puddingsteve/8-Bit-CPU/Uploads/Schematics/ALU.png

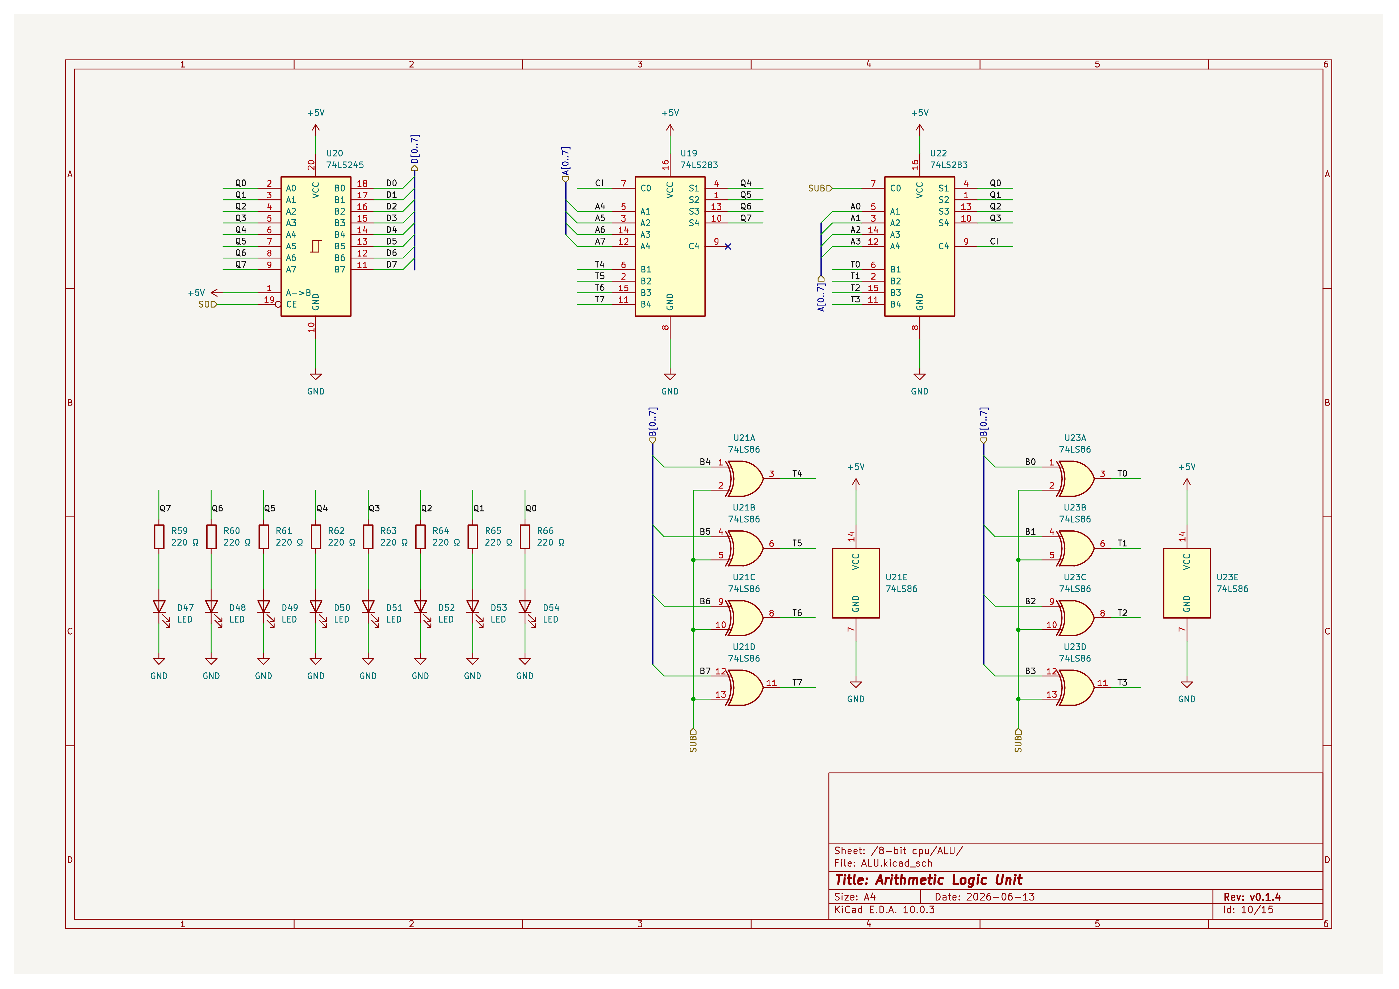
Uploads/Schematics/ALU.png
