puddingsteve/8-Bit-CPU/Uploads/Schematics/Bus Monitor.png

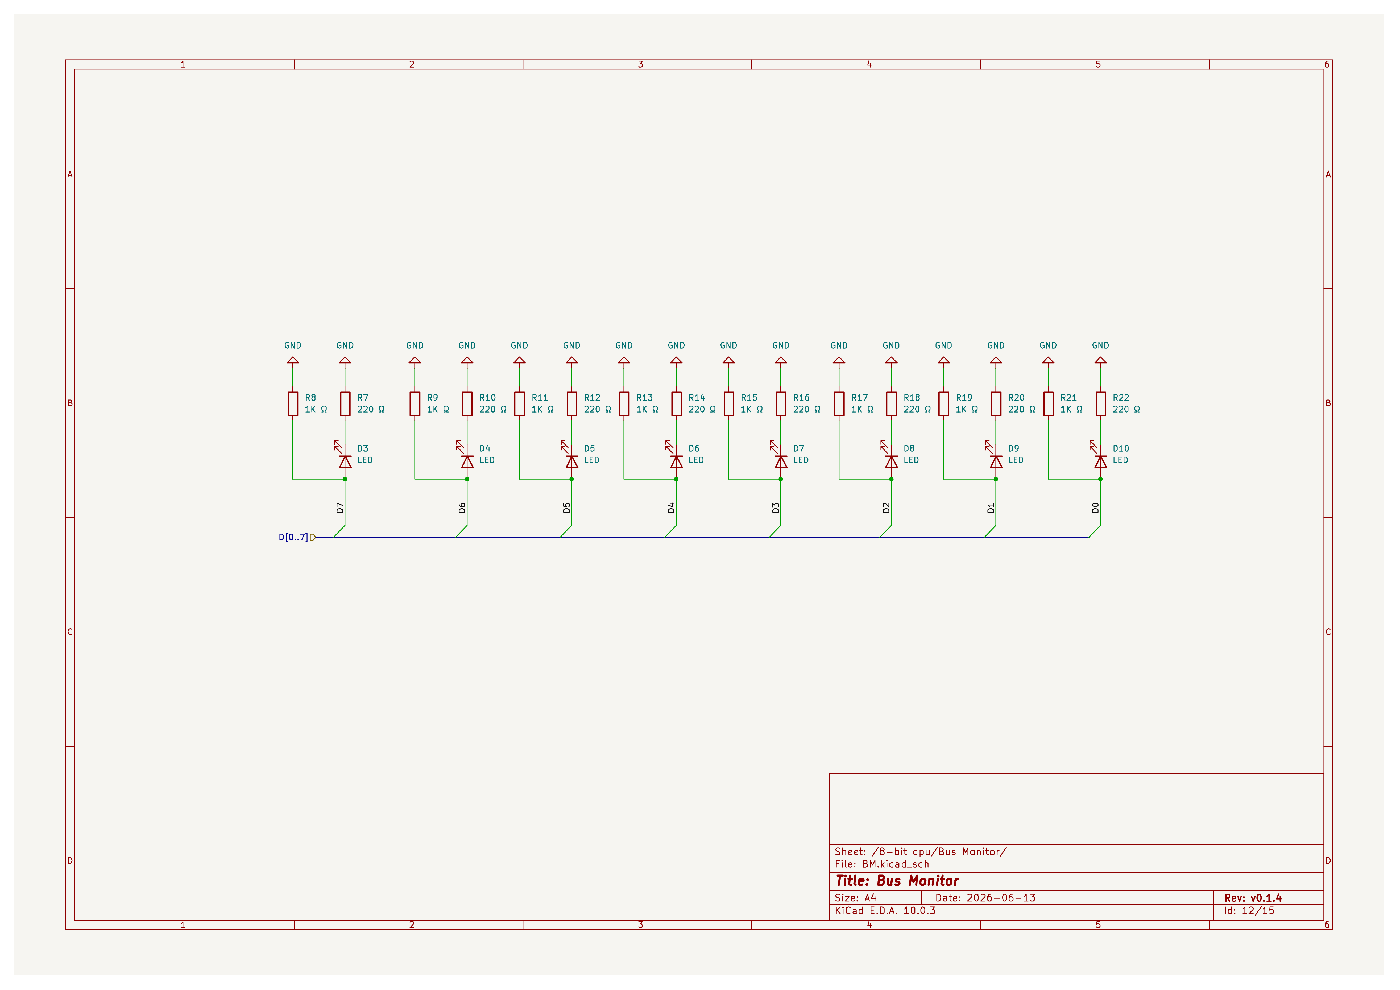
Uploads/Schematics/Bus Monitor.png
