puddingsteve/8-Bit-CPU/Uploads/Schematics/Clock.png

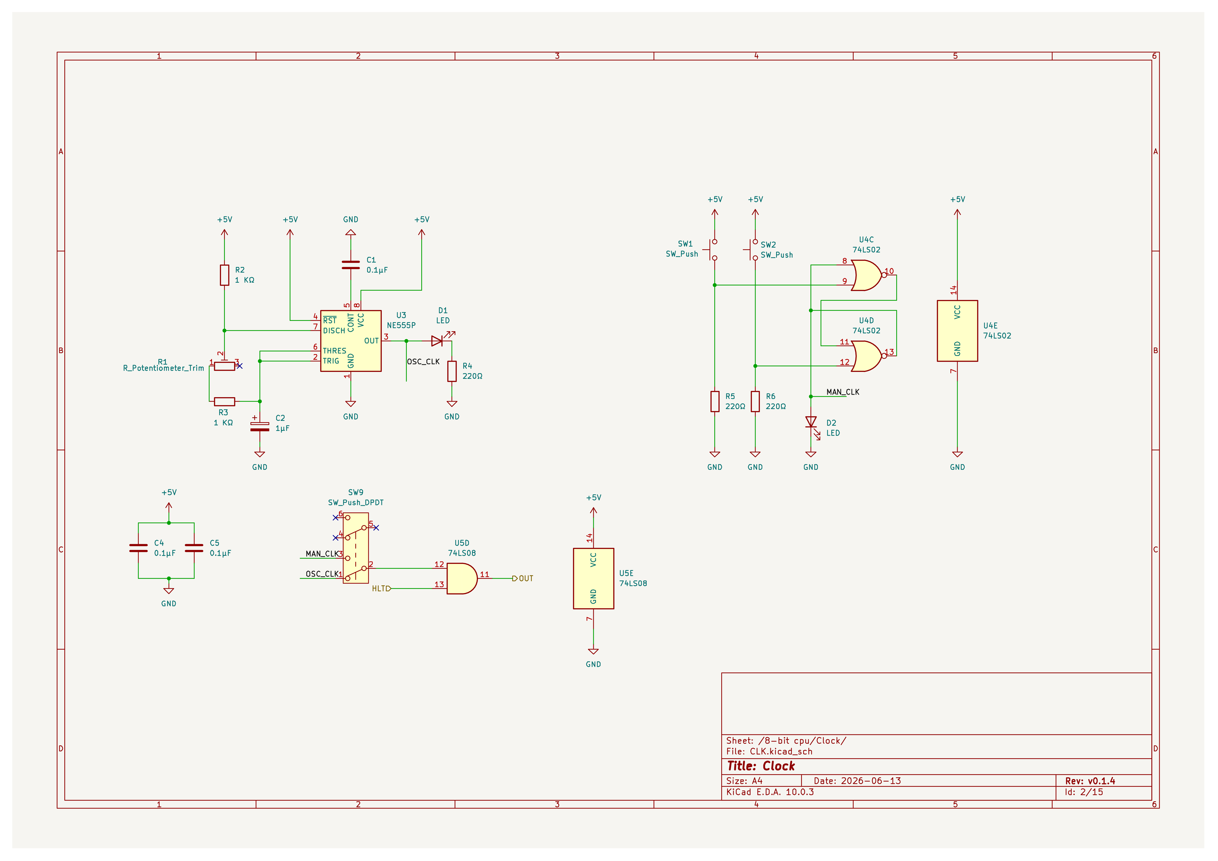
Uploads/Schematics/Clock.png
