puddingsteve/8-Bit-CPU/Uploads/Schematics/Control Unit.png

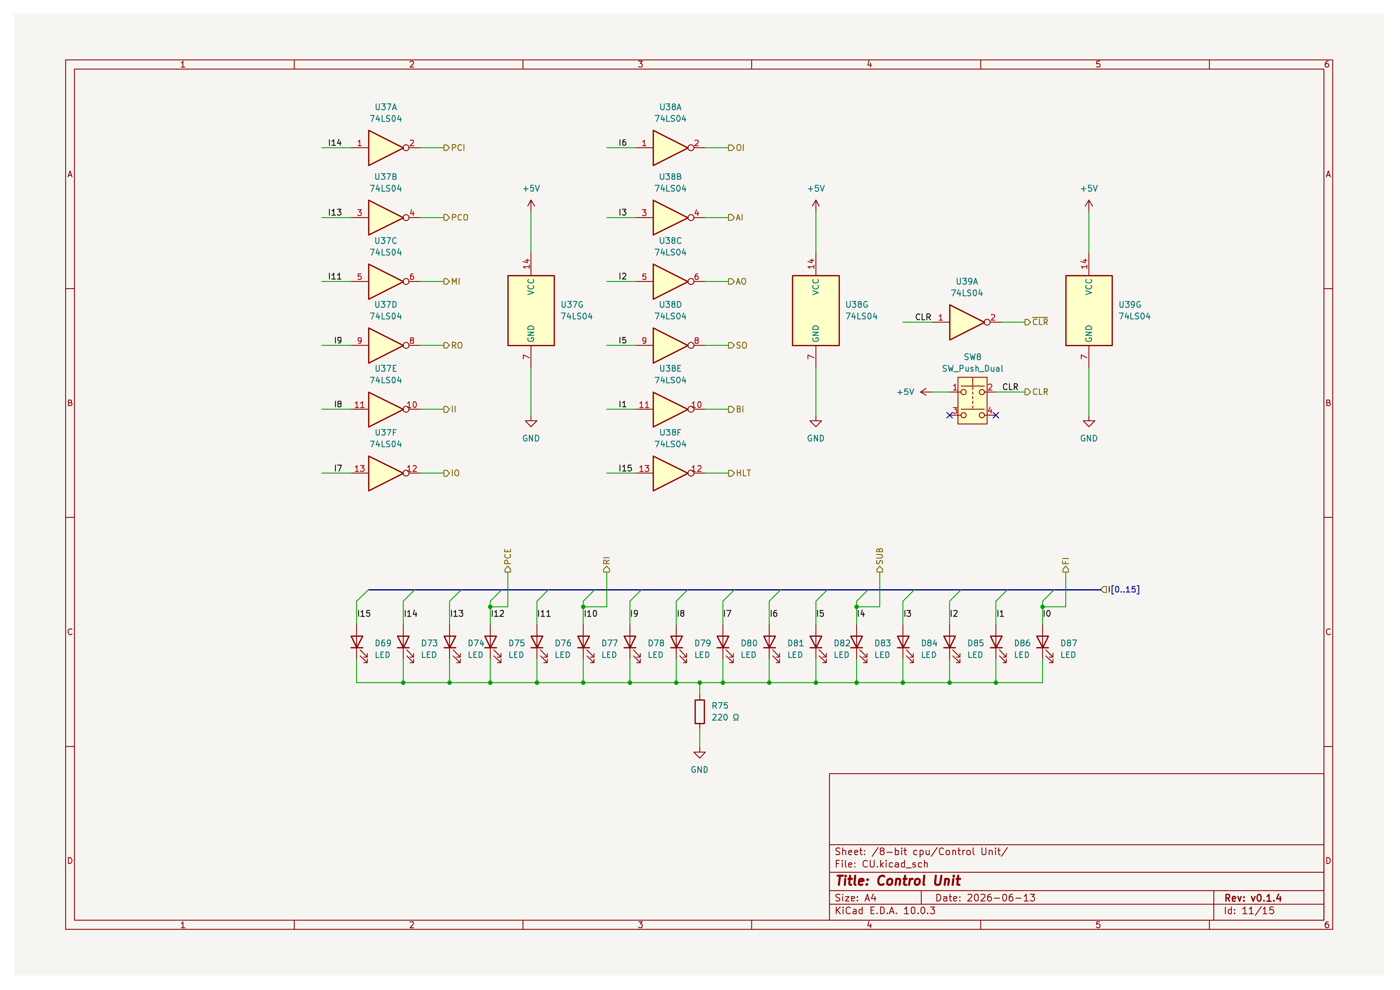
Uploads/Schematics/Control Unit.png
