puddingsteve/8-Bit-CPU/Uploads/Schematics/EEPROM.png

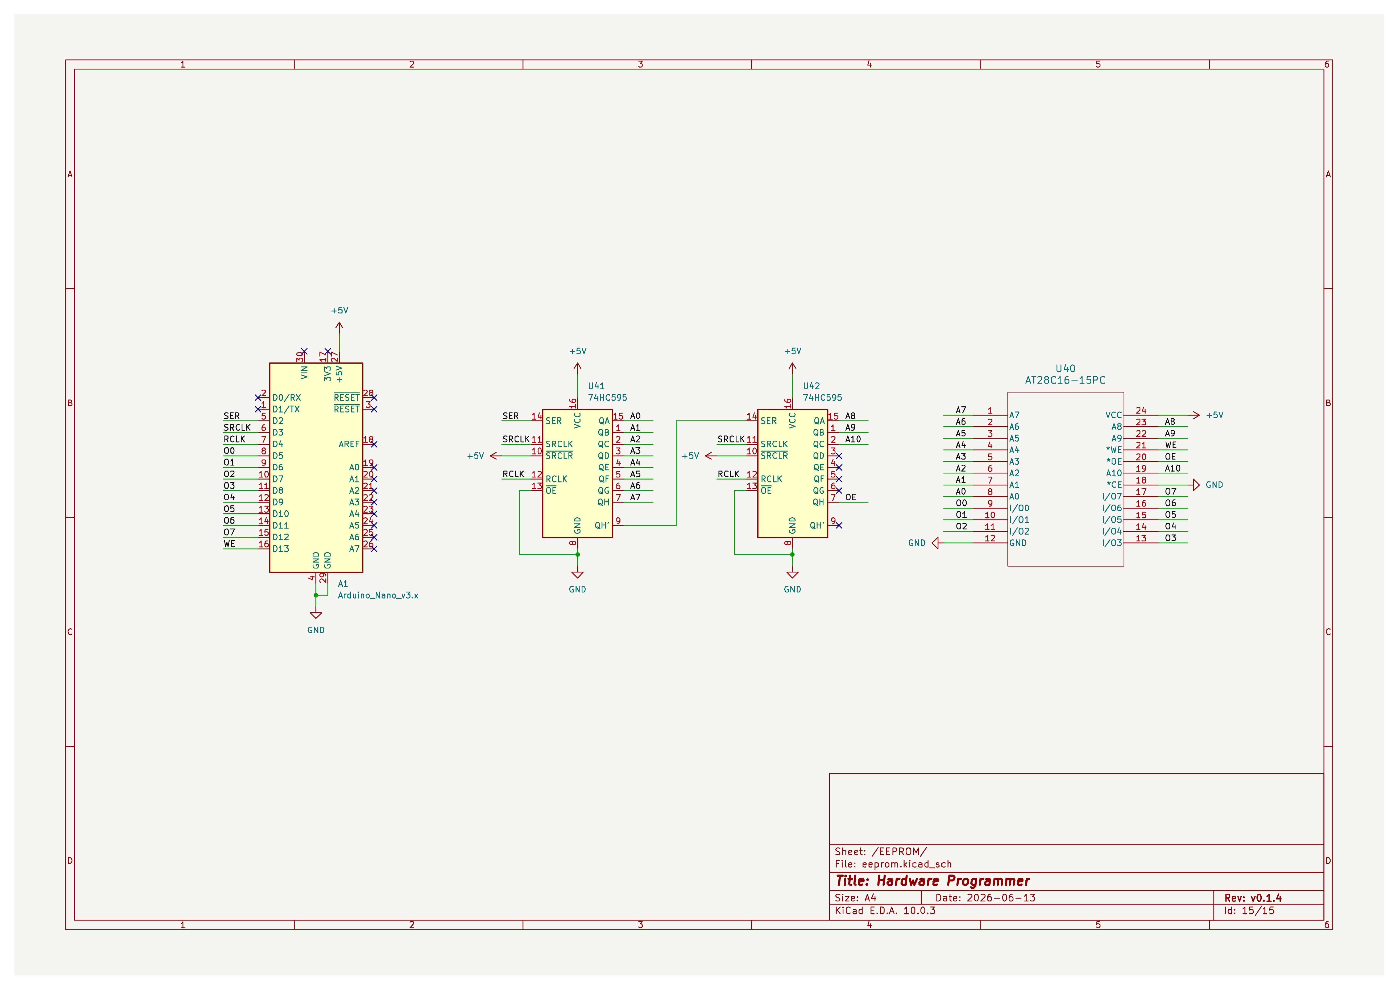
Uploads/Schematics/EEPROM.png
