puddingsteve/8-Bit-CPU/Uploads/Schematics/Flag Register.png

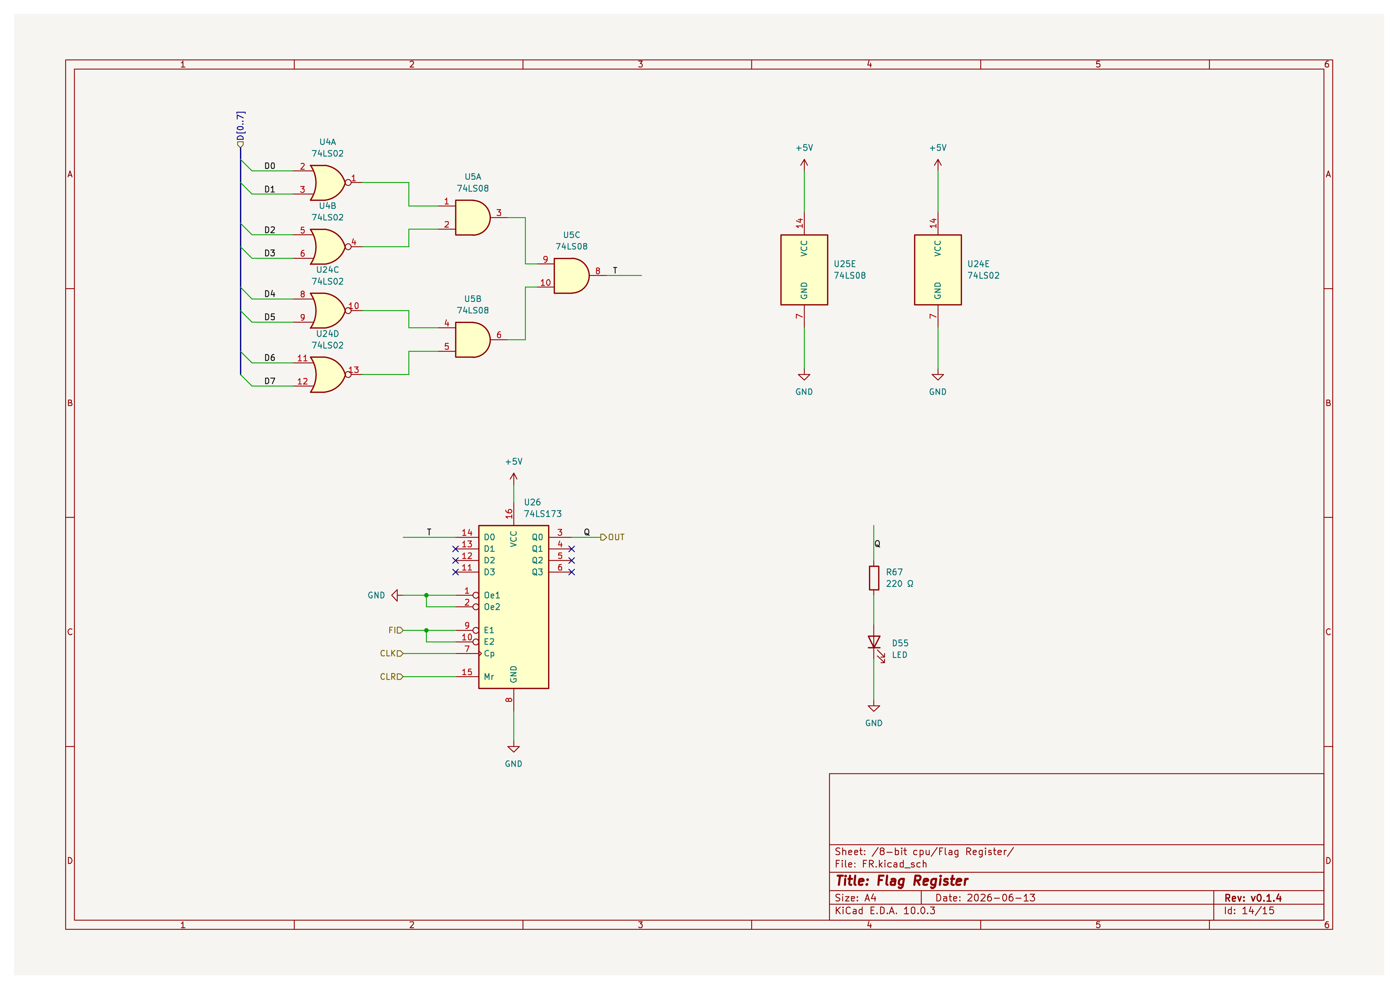
Uploads/Schematics/Flag Register.png
