puddingsteve/8-Bit-CPU/Uploads/Schematics/Output Register.png

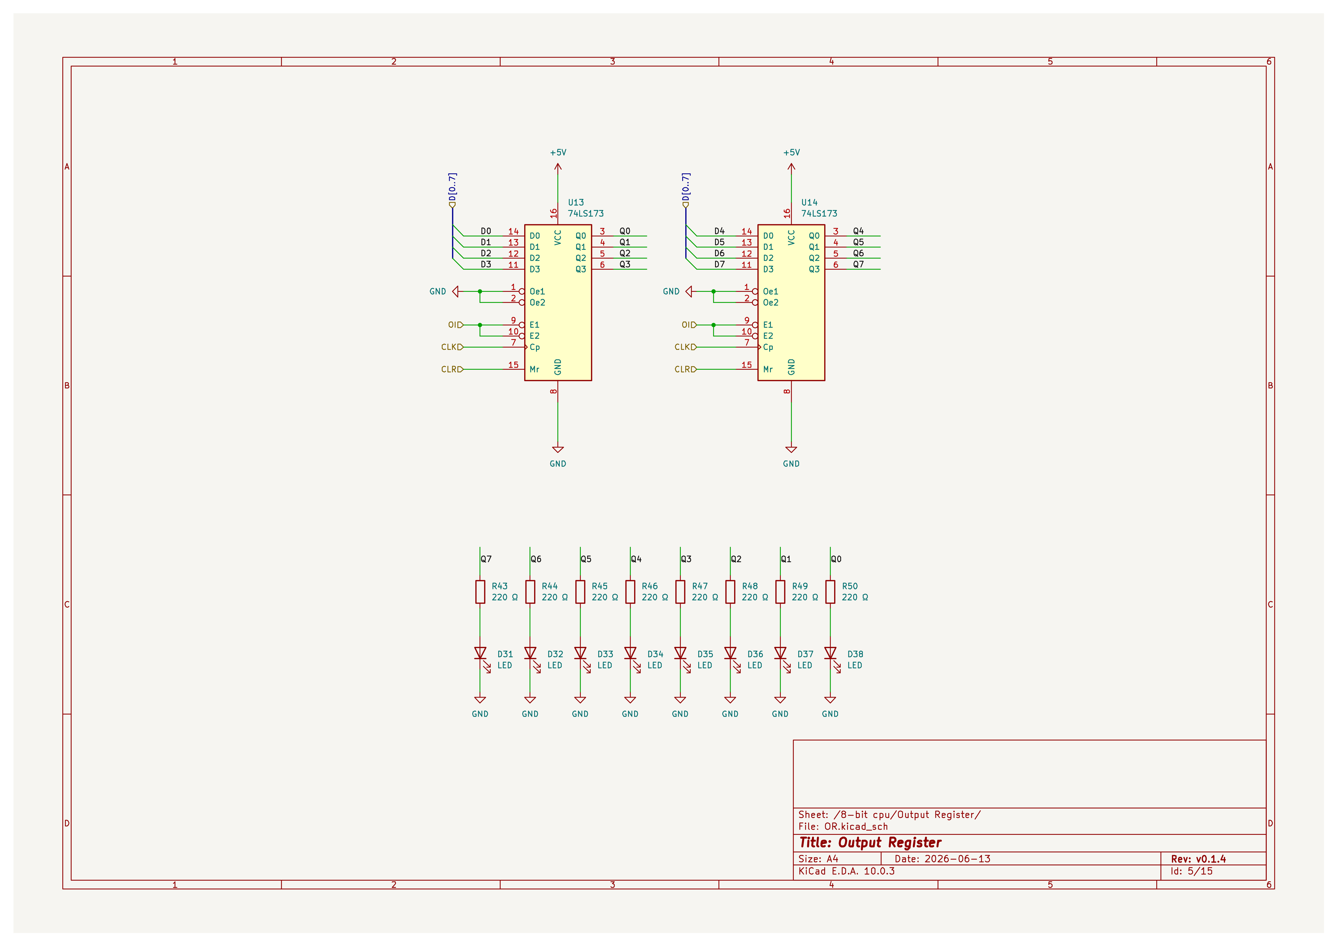
Uploads/Schematics/Output Register.png
