puddingsteve/8-Bit-CPU/Uploads/Schematics/Program Counter.png

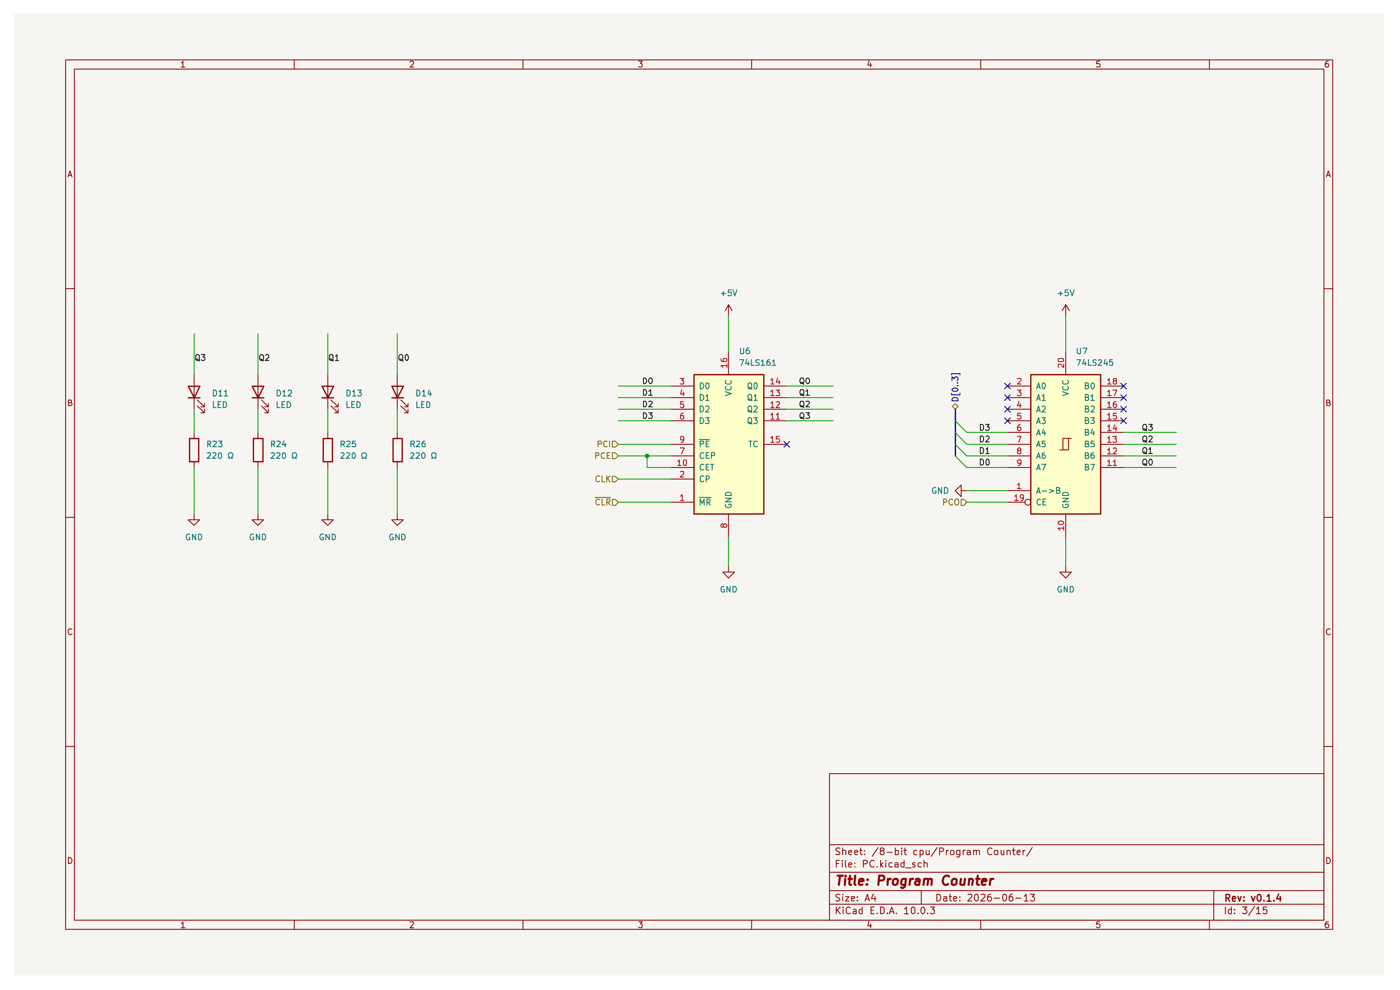
Uploads/Schematics/Program Counter.png
