puddingsteve/8-Bit-CPU/Uploads/Schematics/RAM.png

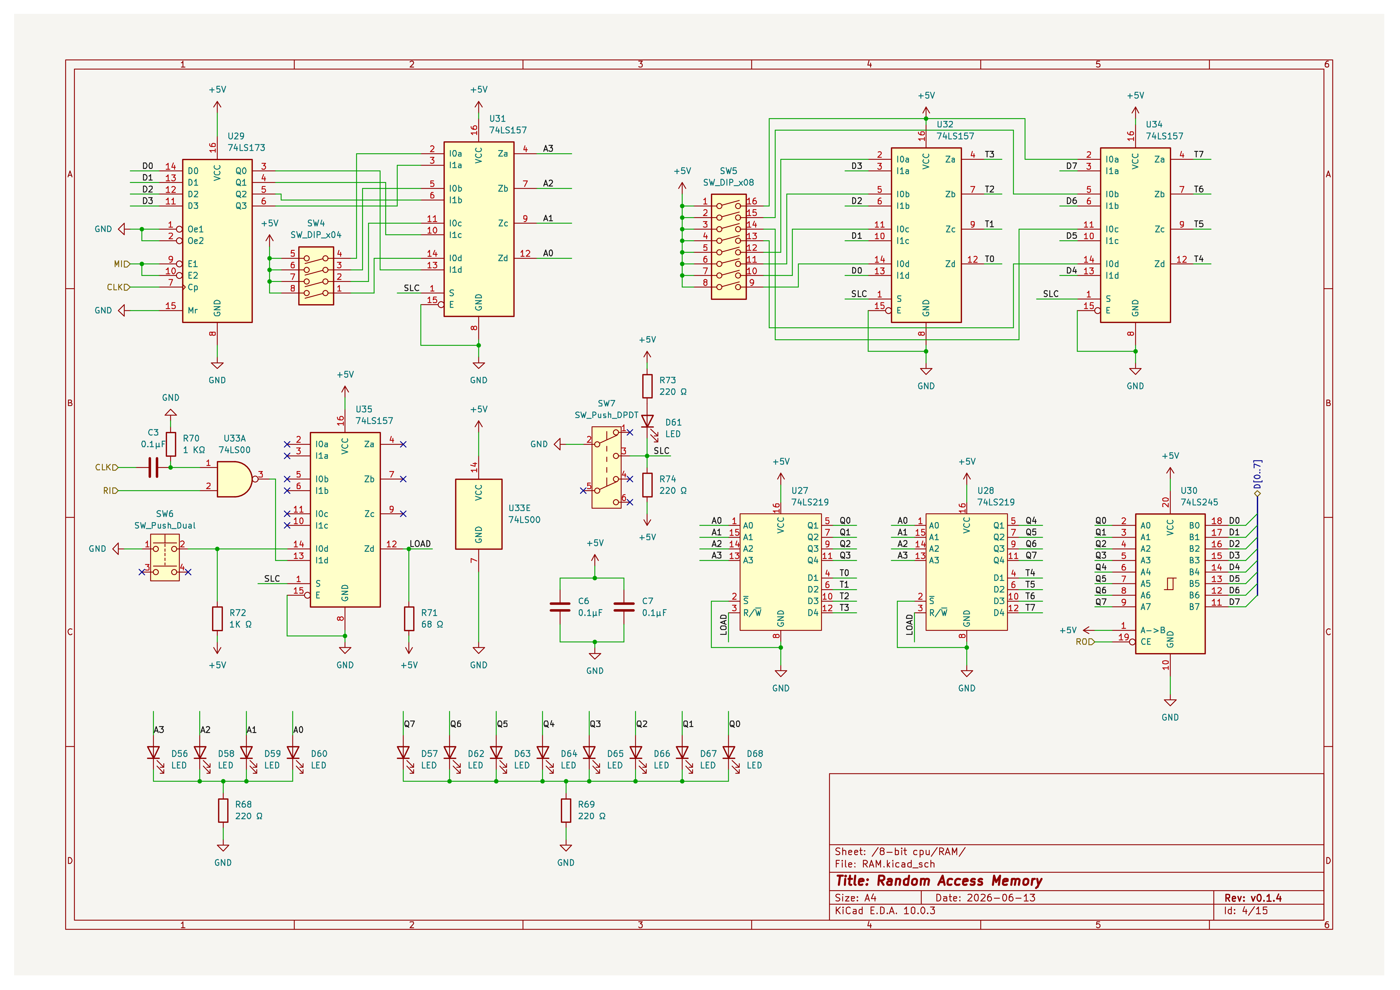
Uploads/Schematics/RAM.png
