puddingsteve/8-Bit-CPU/Uploads/Schematics/Register A.png

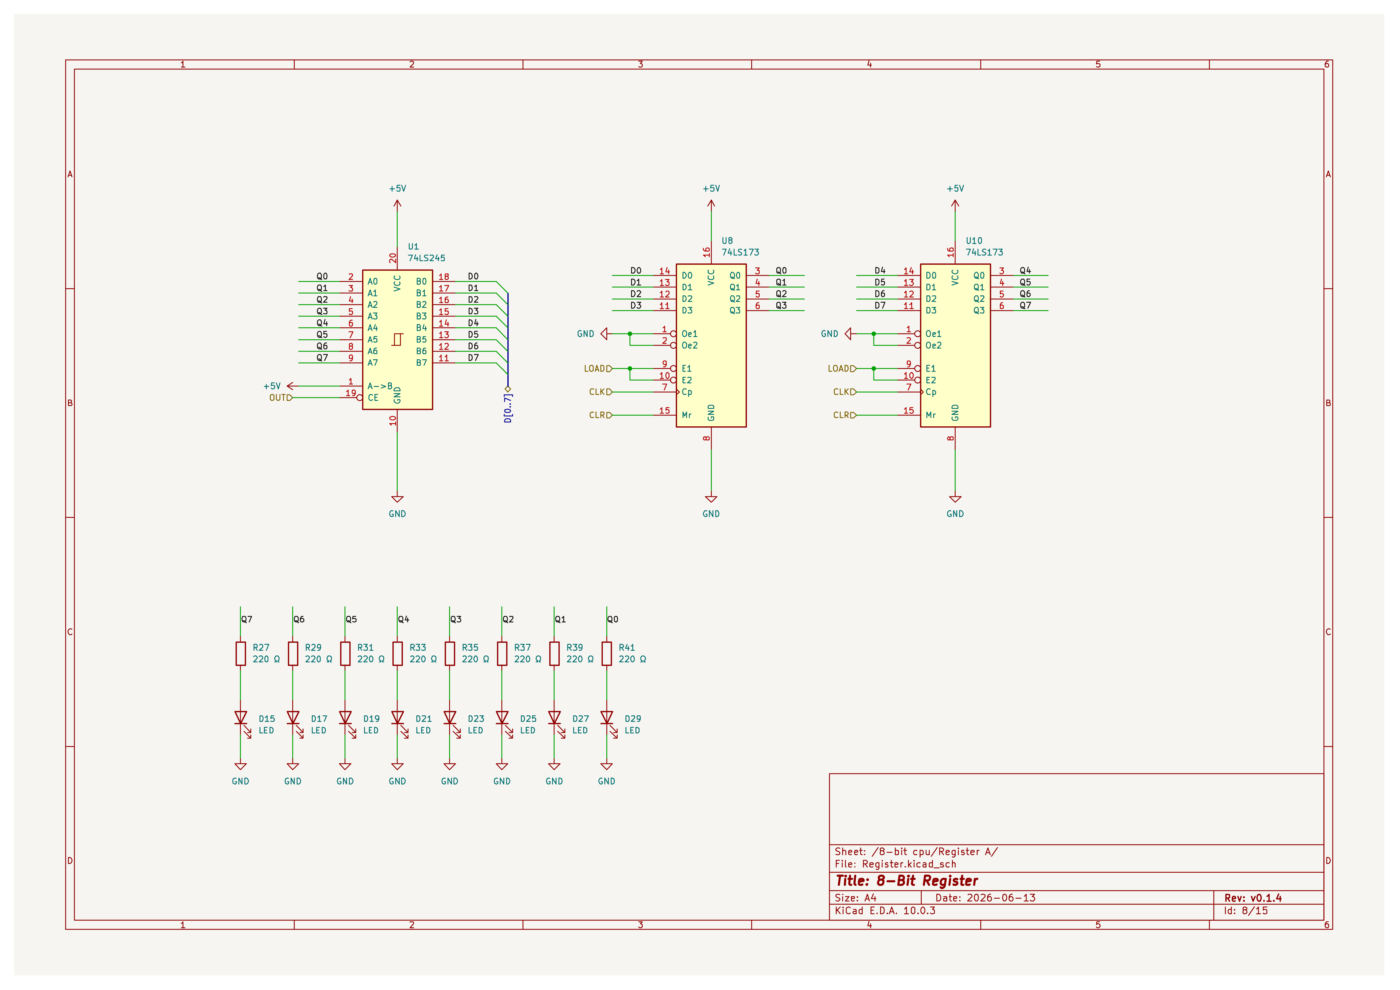
Uploads/Schematics/Register A.png
