puddingsteve/8-Bit-CPU/Uploads/Schematics/Top Sheet.png

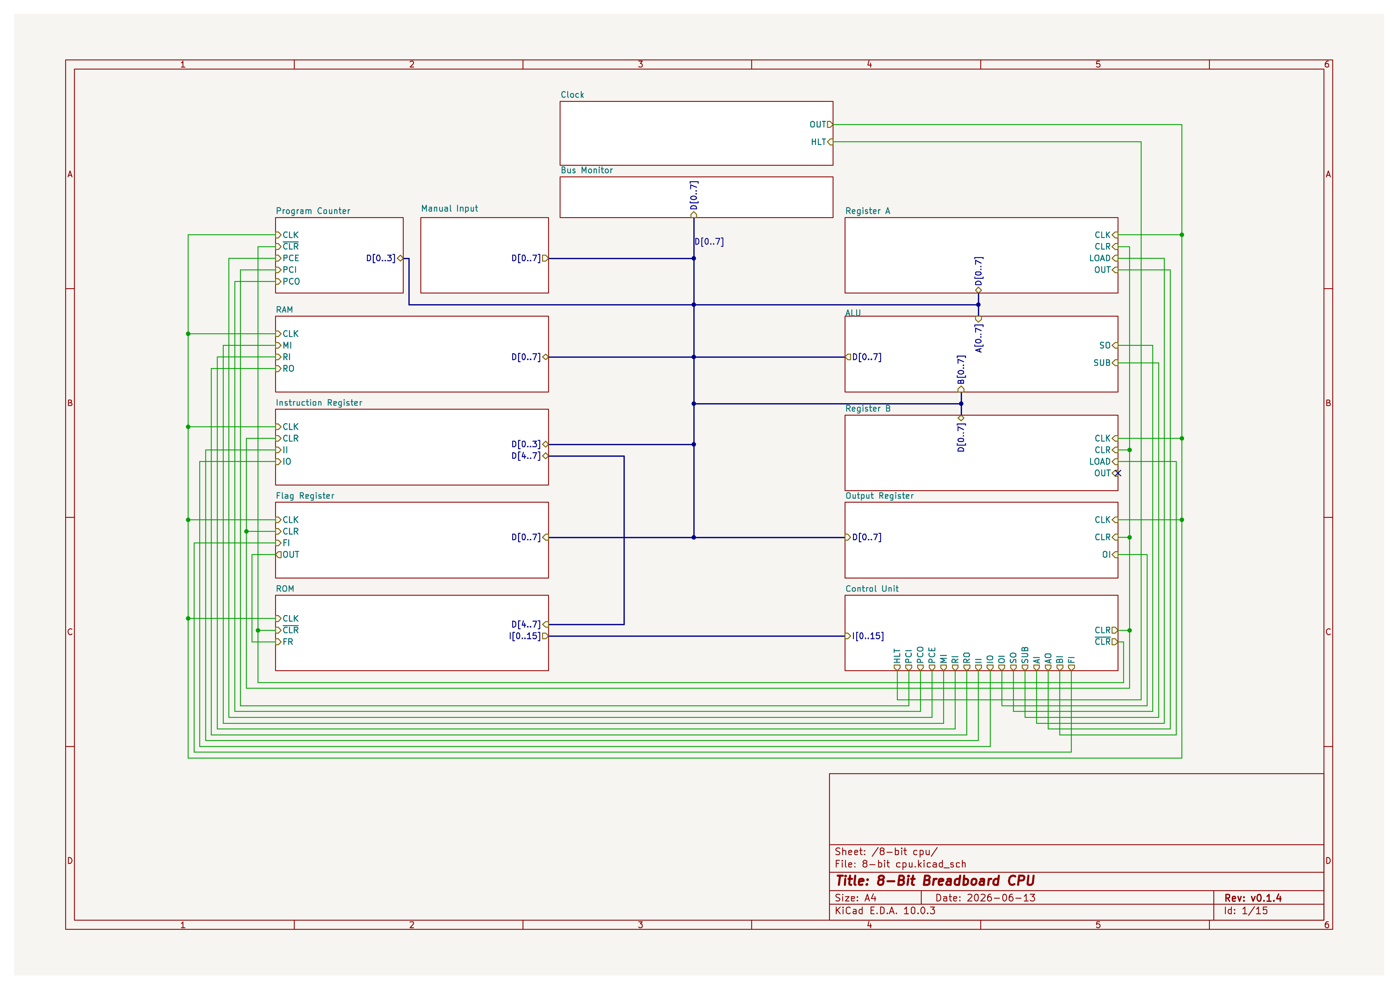
Uploads/Schematics/Top Sheet.png
