puddingsteve/8-Bit-CPU/Uploads/Schematics/Instruction Decoder.png

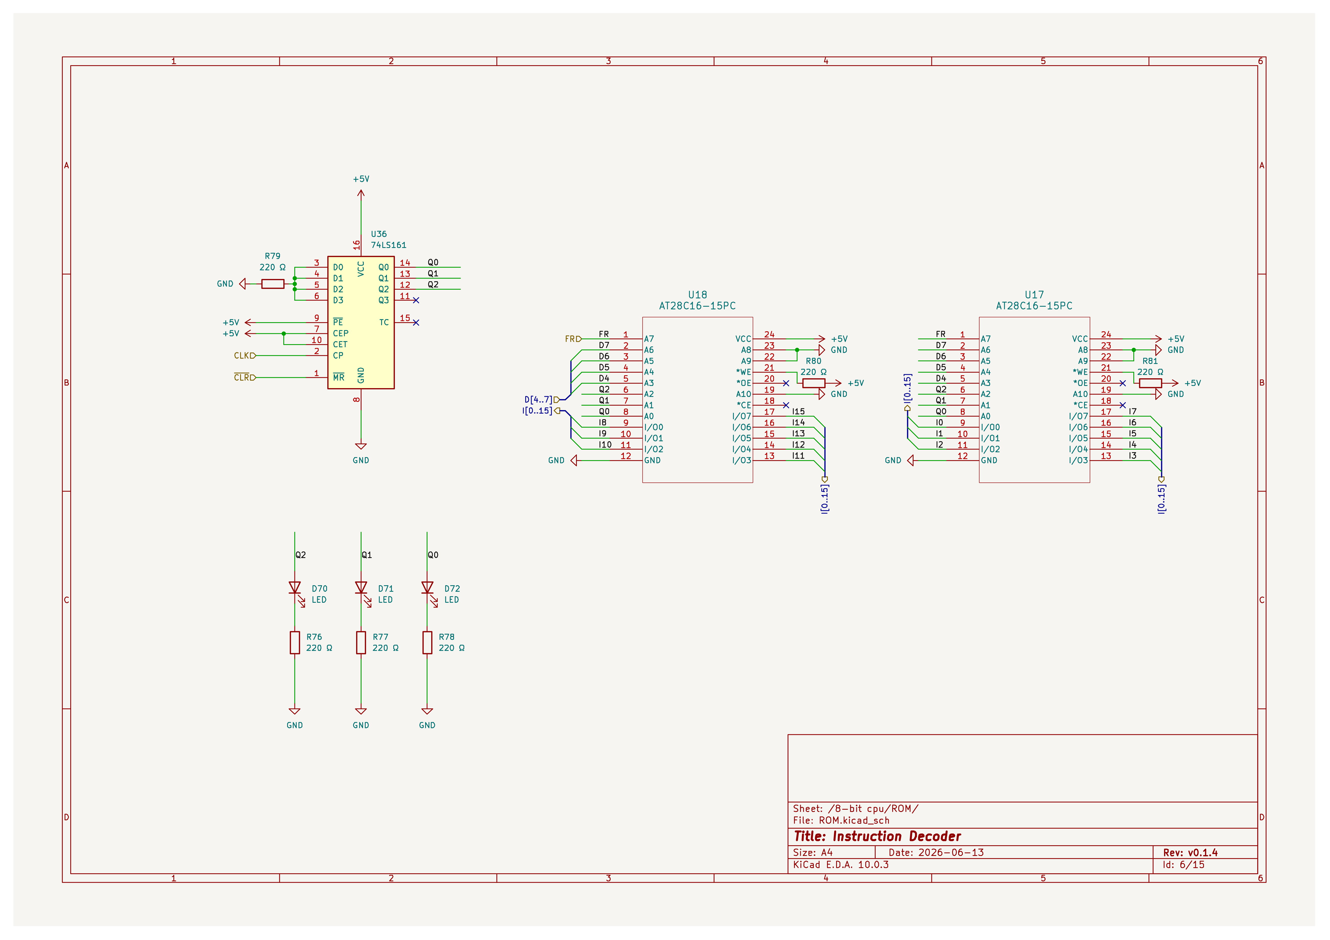
Uploads/Schematics/Instruction Decoder.png
