puddingsteve/8-Bit-CPU/Uploads/Schematics/Instruction Register.png

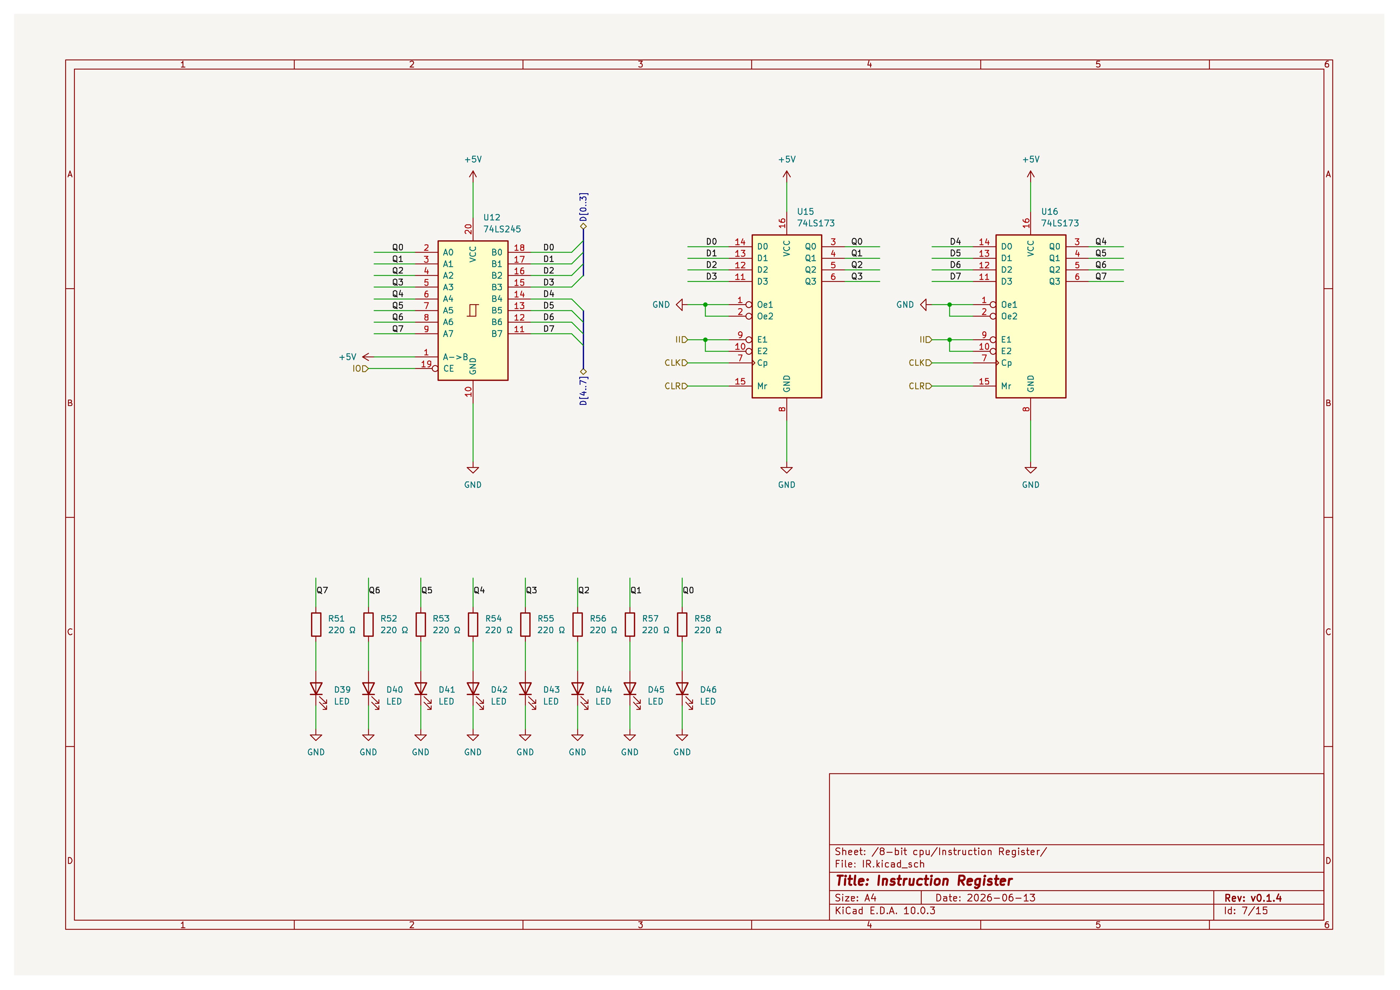
Uploads/Schematics/Instruction Register.png
