puddingsteve/8-Bit-CPU/Uploads/Schematics/Manual Input.png

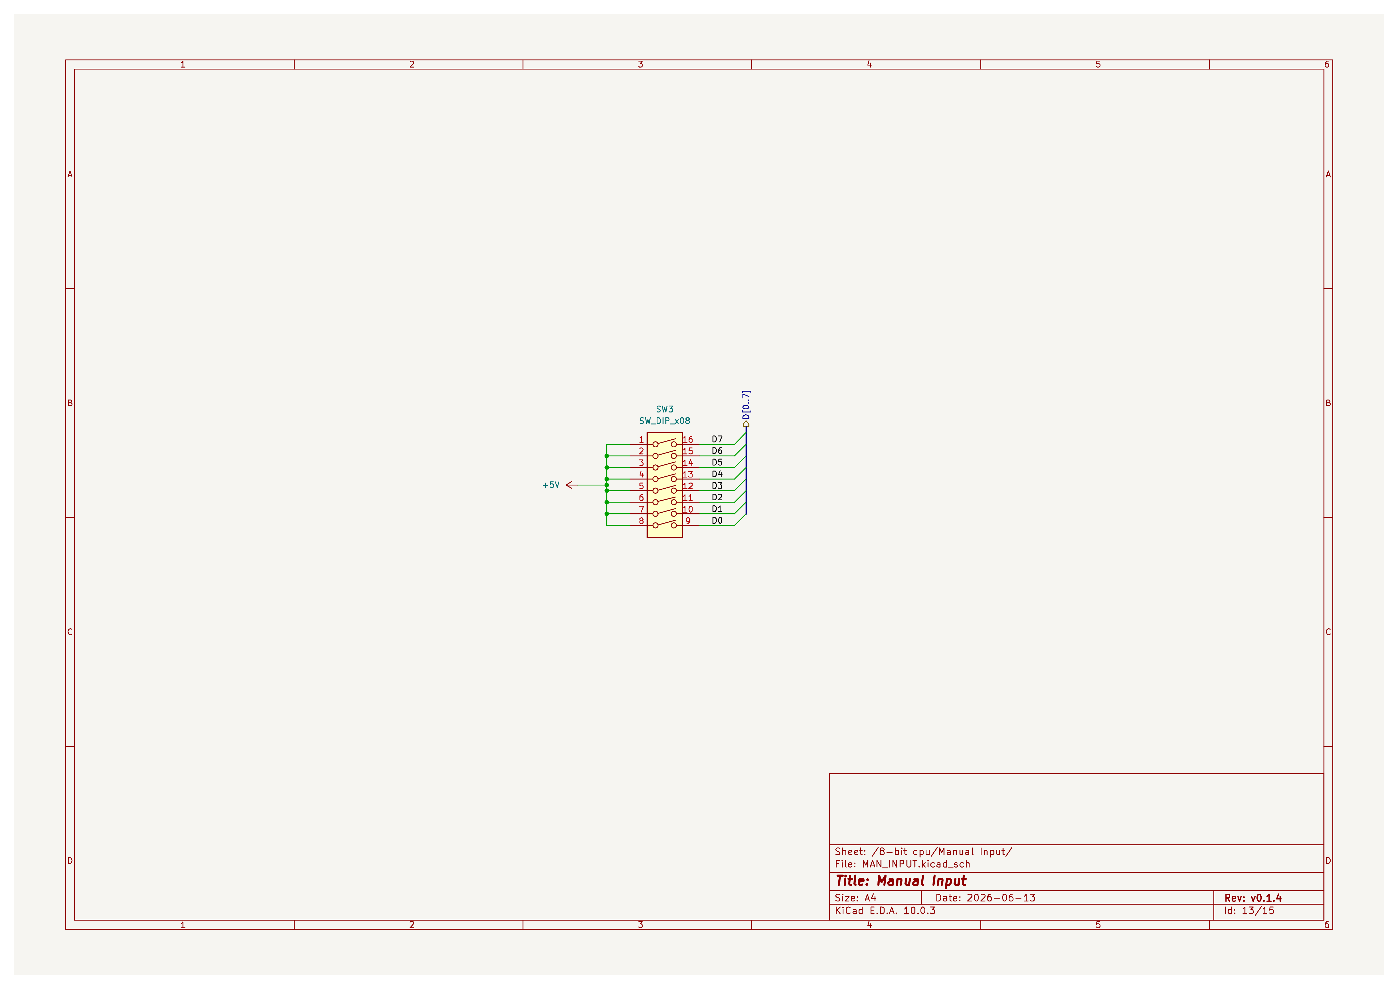
Uploads/Schematics/Manual Input.png
