puddingsteve/8-Bit-CPU/(commit log)

2026-06-14 Refining README, modify Schematics
    [BOM.csv]
2026-06-14 Add link to custom Arduino script in README
    Updated README to include a link to the custom Arduino script for programming EEPROMs.
